moe01324/ESP32_OilTemp/pics/IMG_20200223_084451.jpg

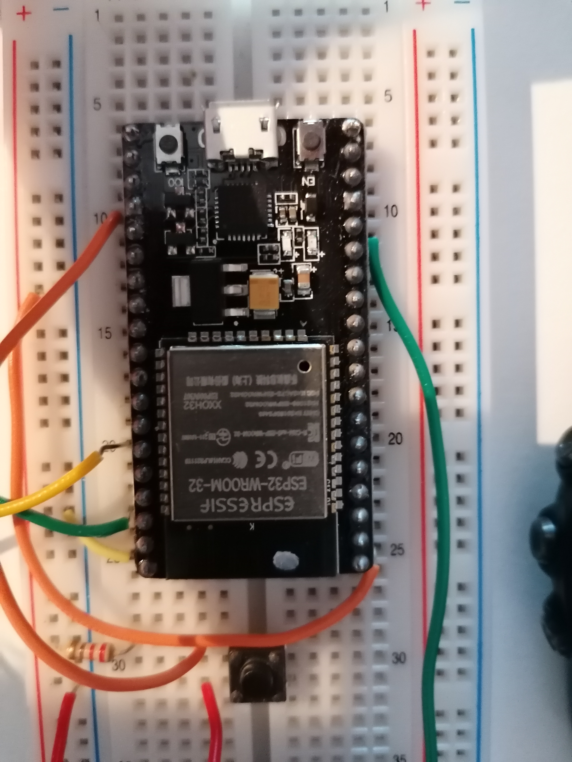
pics/IMG_20200223_084451.jpg
