moe01324/ESP32_OilTemp/pics/IMG_20200228_210141.jpg

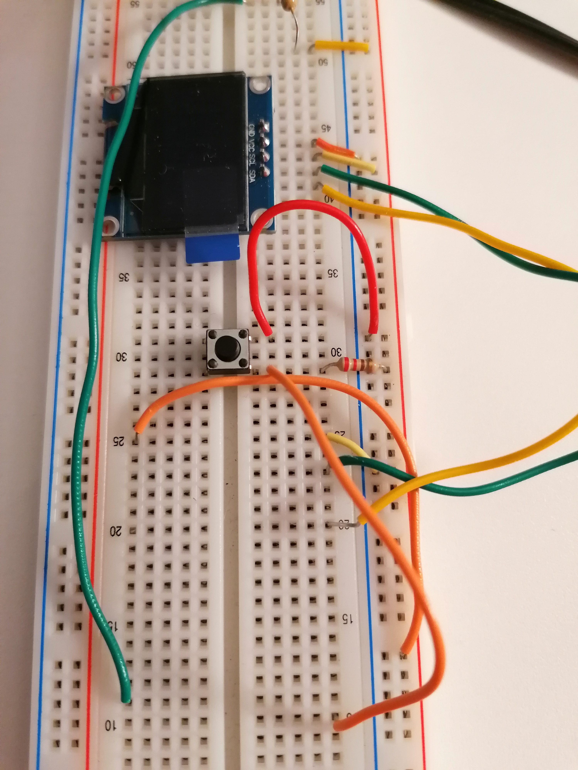
pics/IMG_20200228_210141.jpg
